zengcym/HDMI-To-MIPI/Images/2.jpg

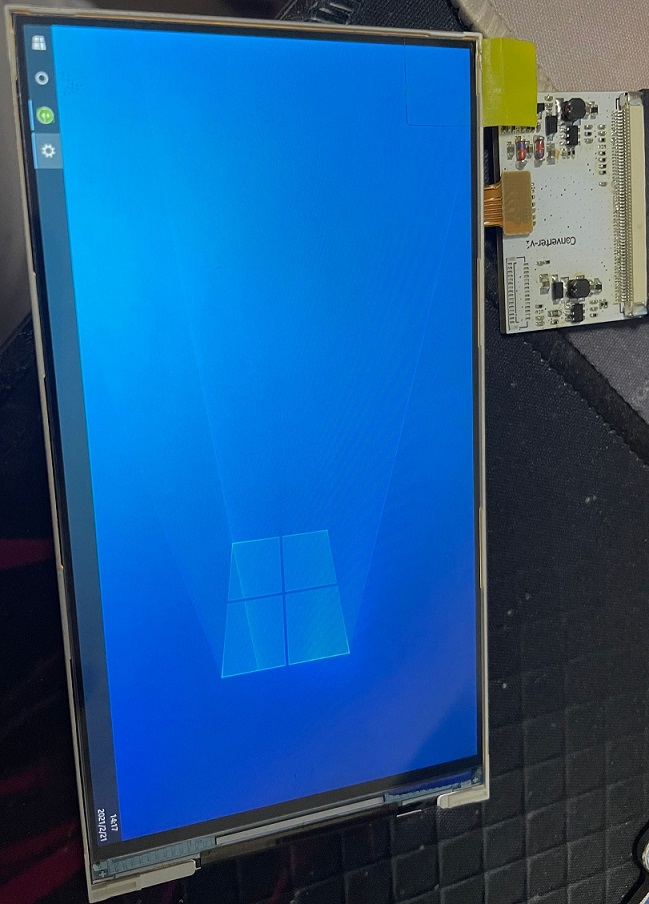
Images/2.jpg
