zengcym/HDMI-To-MIPI/Images/3.jpg

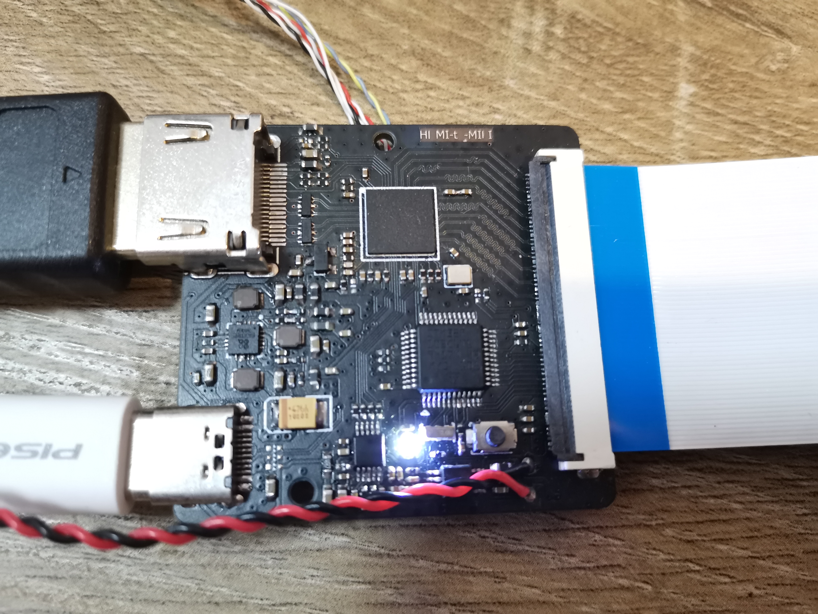
Images/3.jpg
