zengcym/HDMI-To-MIPI/Images/8-1.jpg

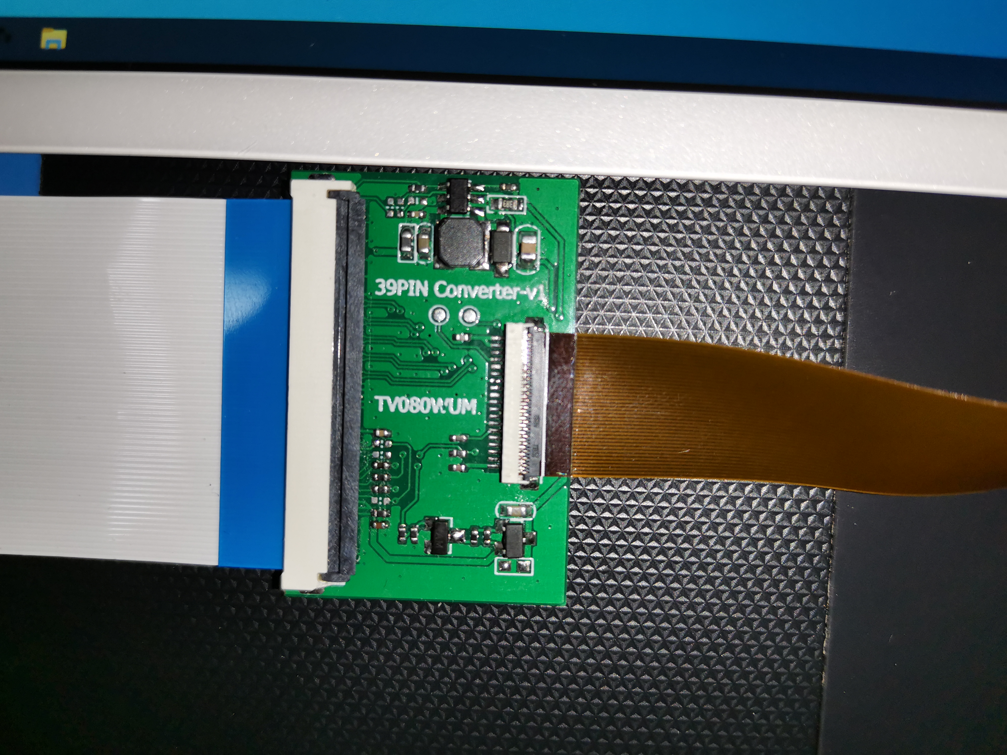
Images/8-1.jpg
