zengcym/HDMI-To-MIPI/Images/8.jpg

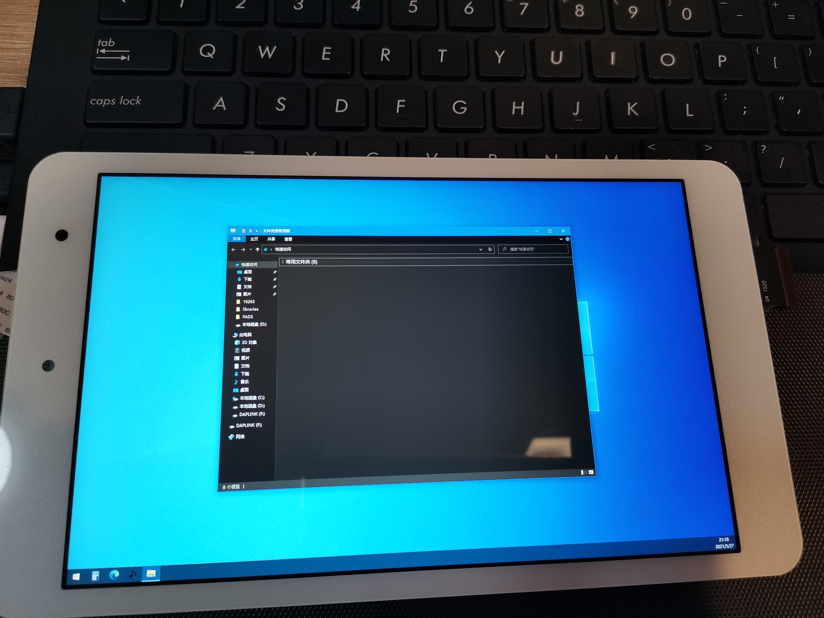
Images/8.jpg
