zengcym/HDMI-To-MIPI/Hardware/TC358870/HDMI to MIPI_v1 核心板BOM_V1.xlsx

Value | Decal | qty | Name
 |  | 5
 | TYPE-C-TOP | 1 | USB1
NS4150B | MSS0P8 | 1 | R52
ES7144LV | MSS0P10 | 1 | R45
EA3036C | QFN-20 | 1 | U1
SG-210STF 48M 2520 | ILFH2520 | 1 | U4
STM32F103CBT6 | LQFP-48 | 1 | U2
TC358870XBG | VFBGA-80 | 1 | U3
 |  | 59
0R | RES_0402 | 1 | R23
10R | L0603AA | 1 | R47
22R | RES_0402 | 2 | R5 R7
33R | RES_0402 | 9 | R15 R16 R21 R22 R28 R35 R36 R37 R38
470R | RES_0402 | 2 | R48 R49
1K | RES_0402 | 5 | R32 R33 R41 R42 R55
1.5K | RES_0402 | 2 | R39 R58
2K | RES_0402 | 3 | R10 R13 R26
10K | RES_0402 | 7 | R3 R8 R9 R18 R19 R50 R51
15K | RES_0402 | 1 | R6
27K | RES_0402 | 1 | R44
30K | RES_0402 | 3 | R53 R54 R59
47K | RES_0402 | 3 | R30 R31 R43
68K | RES_0402 | 1 | R4
91K | RES_0402 | 1 | R11
100K | RES_0402 | 3 | R2 R12 R57
200K | RES_0402 | 1 | R1
FB120R磁珠 | L0603AA | 7 | L5 R14 R17 R20 R27 R34 R56
10K | RES_0402 | 4 | R24 R25
2SC2712 | SOT23 | 1 | R40
 |  | 61
5P | CAP_0402 | 1 | C27
0.1U | CAP_0402 | 34 | C2 C3 C4 C5 C6 C8 C9 C10 C11 C12 C13 C14 C16 C17 C20 C22 C23 C24 C25 C26 C29 C31 C33 C34 C37 C38 C41 C42 C43 C46 C47 C48 C49 C56
1U | CAP_0402 | 2 | C39 C45
2.2U | CAP_0402 | 8 | C15 C21 C30 C35 C36 C53 C54 C55
4.7U | CAP_0402 | 1 | C40
10U | CAP_0402 | 1 | C32
10U | L0603B | 7 | C1 C7 C50 C51 C52 C57 C58
47U | 3528 | 1 | C44
RCLAMP0524PATCT | SLP2510P8 | 2 | E1 E2
NC | CAP_0402 | 4 | C18 C19 C28 C59
 |  | 7
1.5UH-252012H | 2520-L | 3 | L1 L2 L3
10UH | L0603AA | 1 | L4
10UF | L0603B | 2 | L6 L7
 |  | 2
LEDB | L0603BA | 1 | D1
LEDG | L0603BA | 1 | D2
 |  | 1
CSTCE8M00G52-R0 8MHz | ILFH-3P | 1 | Y1
 |  | 1
60P/0.5MM DOWN | FFC_0.5_60 | 1 | J1
 |  | 16
 | TEST_PTAA | 2 | T6 T7
 | TEST_PTC | 11 | T1 T5 T8 T9 T10 T11 T12 T13 T14 T15 T16
HDMI-19P | HDMI | 1 | HDMI?
3*4 KEY | BUTTONTACT_3X4X2_180H | 1 | K1
NC/4P-1.25-立式 | CON4-1.25MM | 1 | KCON1
