zengcym/HDMI-To-MIPI/Hardware/V2/BOM.xlsx

Value | Decal | qty | Name
0R | R0402 | 1 | R23
10R | R0603 | 1 | R47
33R | R0402 | 11 | R15 R16 R21 R22 R28 R35 R36 R37 R38 R5 R7
470R | R0402 | 2 | R48 R49
1K | R0402 | 5 | R32 R33 R41 R42 R55
1.5K | R0402 | 2 | R39 R58
2K | R0402 | 3 | R10 R13 R26
10K | R0402 | 9 | R3 R8 R9 R18 R19 R24 R50 R51 R61
15K | R0402 | 1 | R6
27K | R0402 | 1 | R44
47K | R0402 | 3 | R30 R31 R43 R53 R54 R59
68K | R0402 | 1 | R4
91K | R0402 | 1 | R11
100K | R0402 | 3 | R2 R12 R57
200K | R0402 | 1 | R1
4.7pF | C0402 | 1 | C27
20pF | C0402 | 2 | C60 C61
100nF | C0402 | 33 | C2 C3 C4 C5 C6 C8 C9 C10 C11 C12 C13 C14 C16 C17 C20 C22 C23 C24 C25 C26 C29 C31 C33 C34 C37 C38 C41 C42 C43 C46 C47 C49 C56
1uF | C0402 | 12 | C39 C45 C15 C21 C30 C32 C35 C36 C53 C54 C55 C40
10uF | C0603 | 9 | C1 C7 C50 C51 C52 C57 C58 L6 L7
