zengcym/HDMI-To-MIPI/Hardware/Converter 转接板/LT070ME05 31PIN V1.pdf

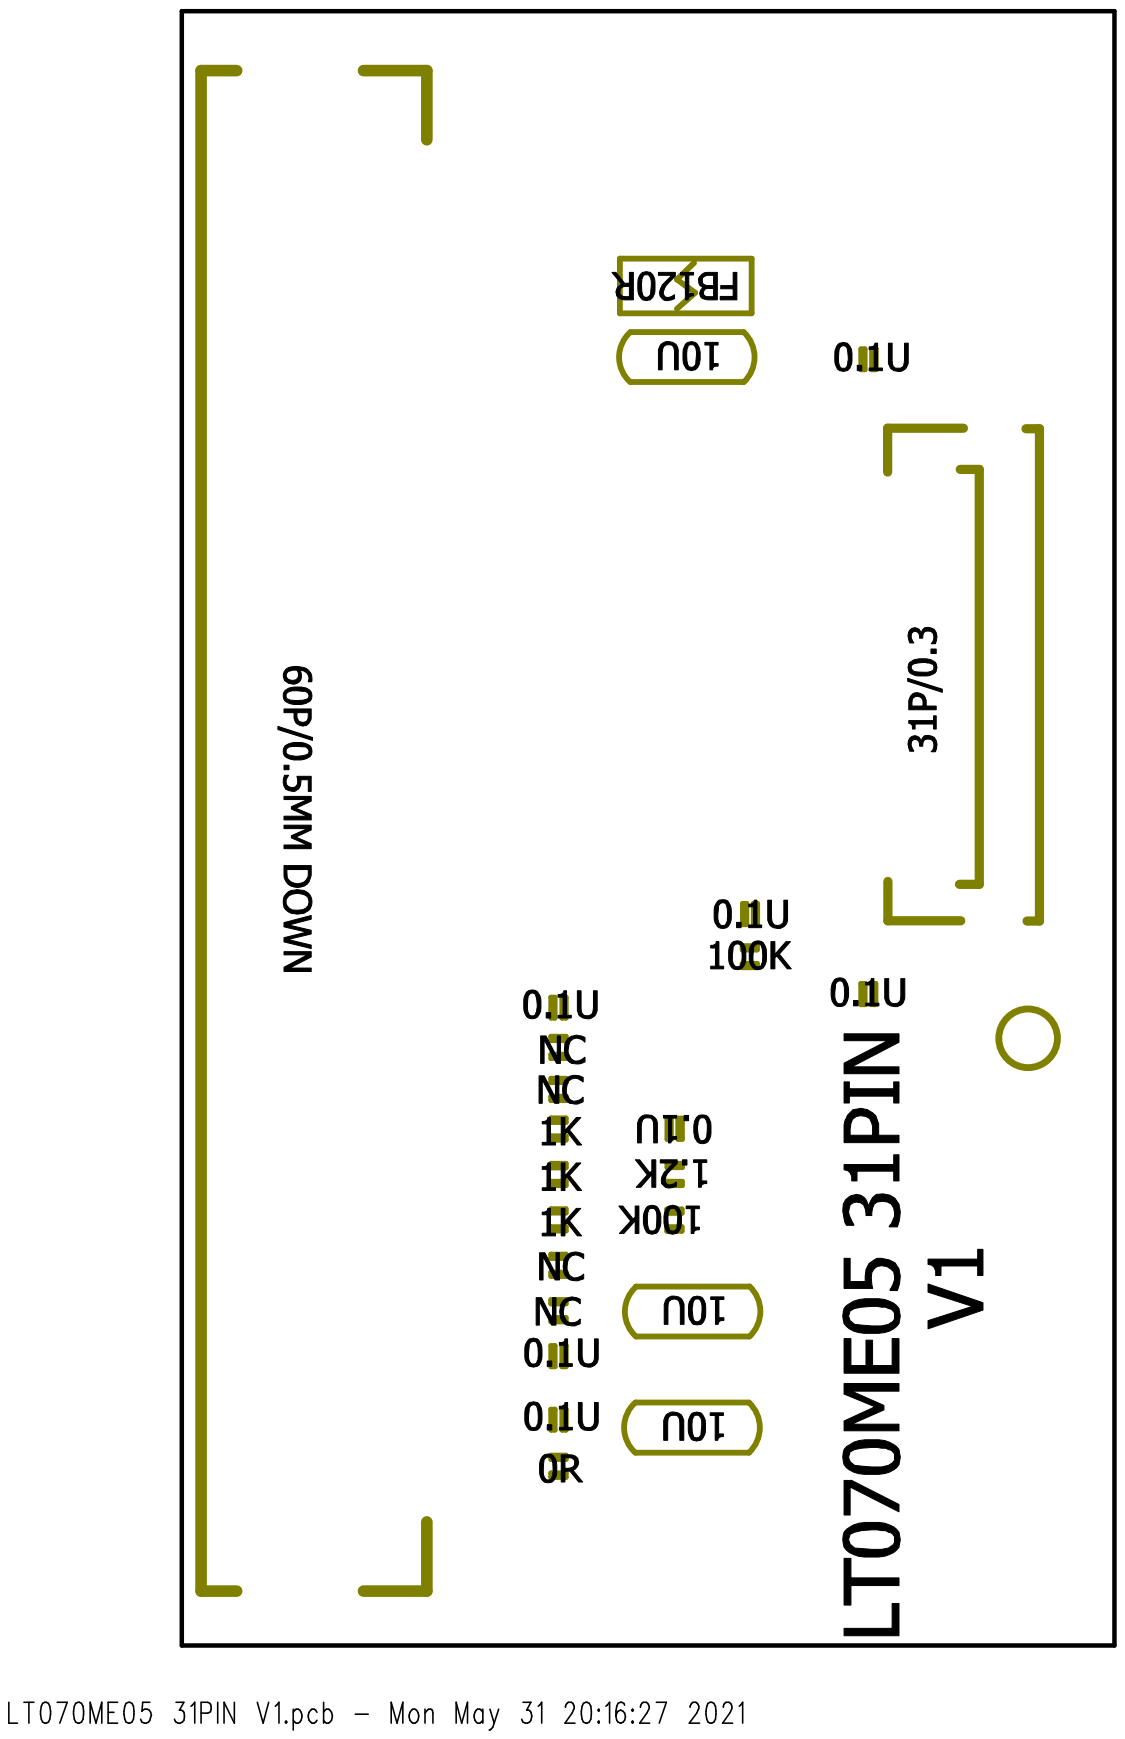
[picture p6: page 1]
