zengcym/HDMI-To-MIPI/Hardware/Converter 转接板/ILI9881C+BOE 10.1寸 Converter_v1.pdf

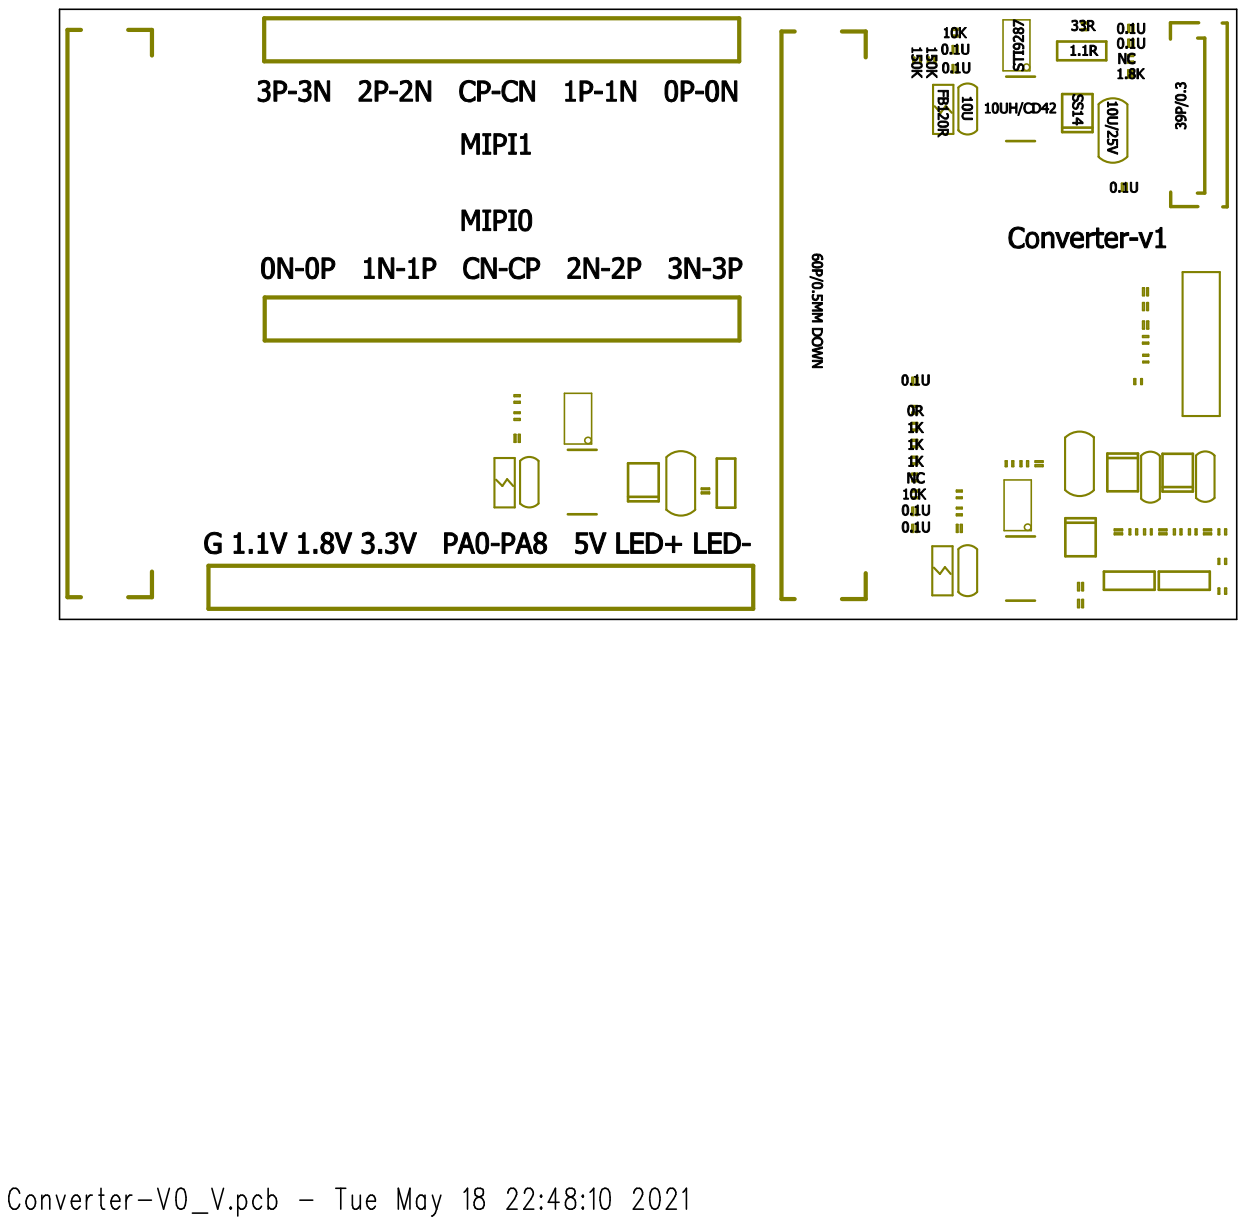
[picture p7: page 1]
