zengcym/HDMI-To-MIPI/Hardware/Converter 转接板/TV101WUM-NM0 51PIN Converter_V1 参数.pdf

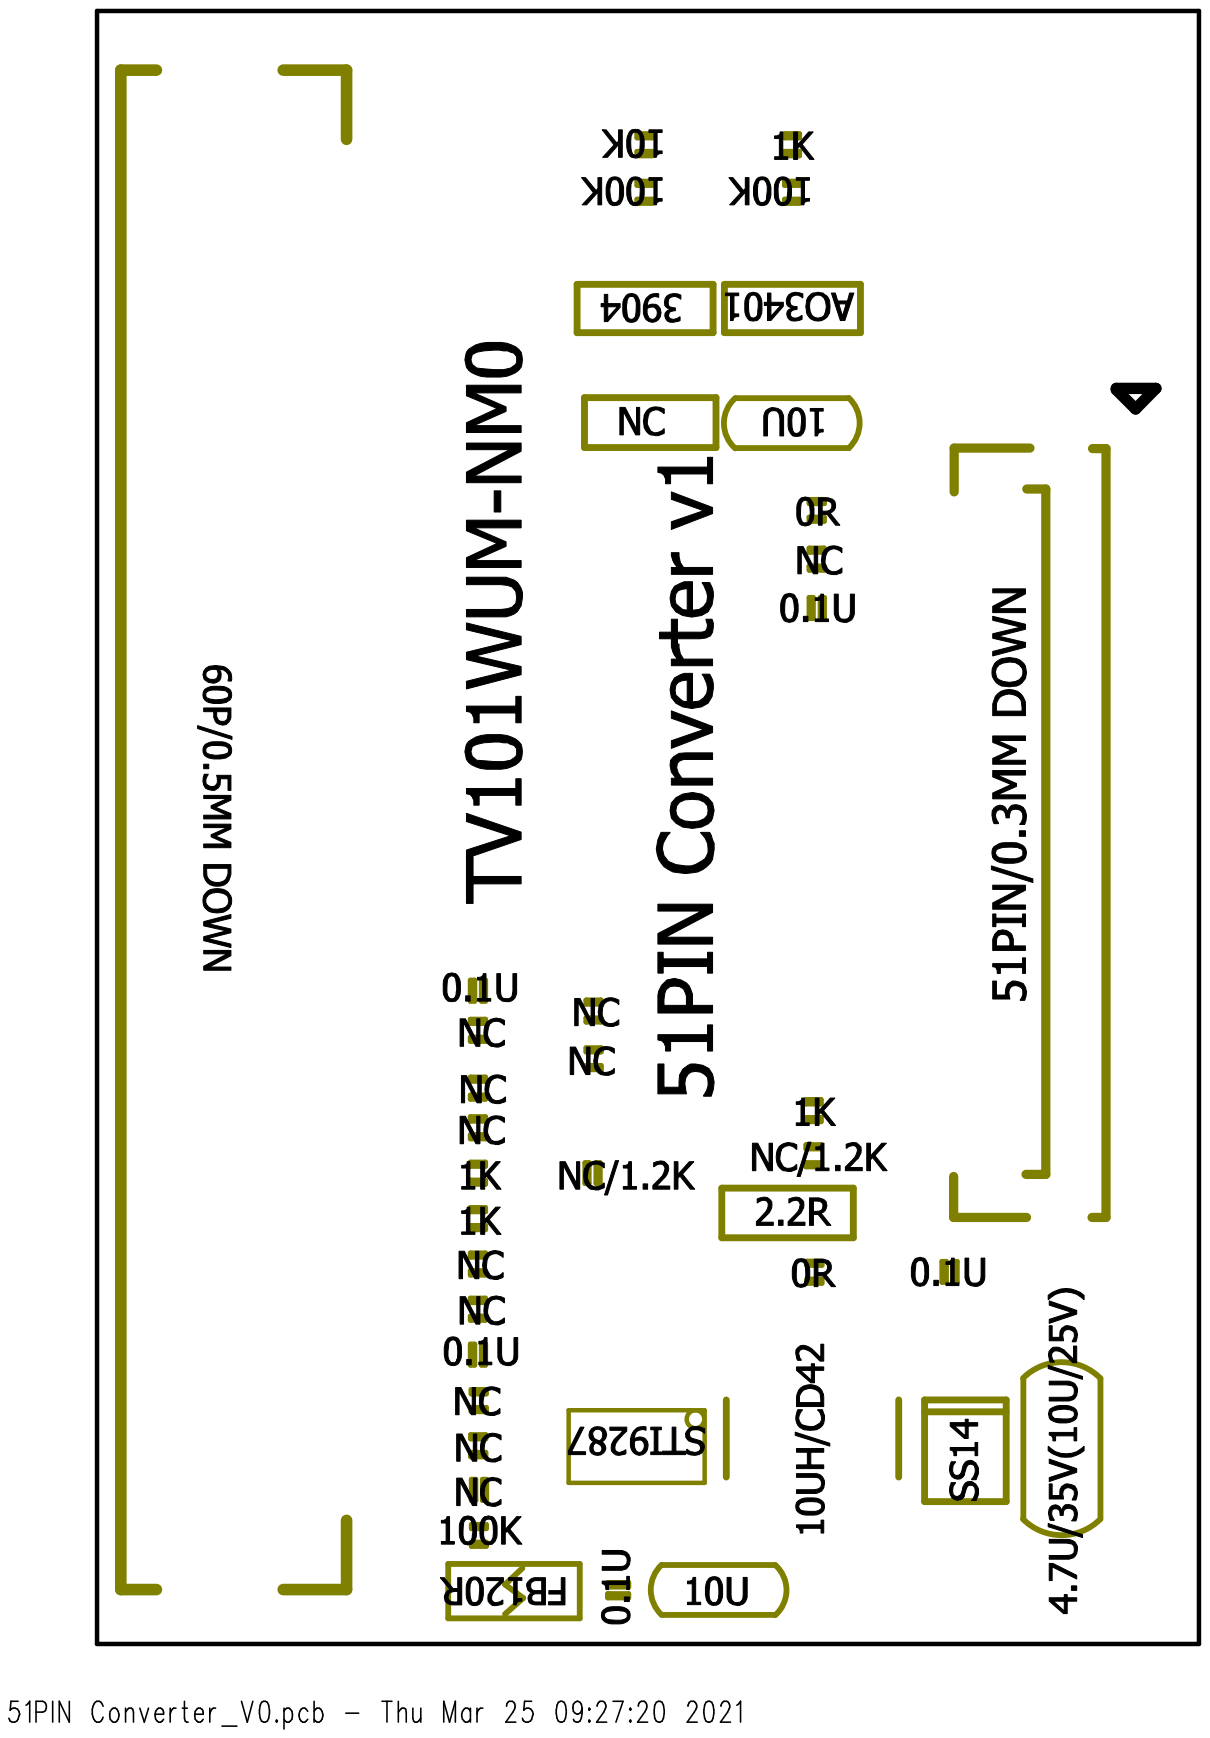
[picture p8: page 1]
