zengcym/HDMI-To-MIPI/Hardware/Converter 转接板/BV050HDM-N00 Converter_v1 参数-更改.pdf

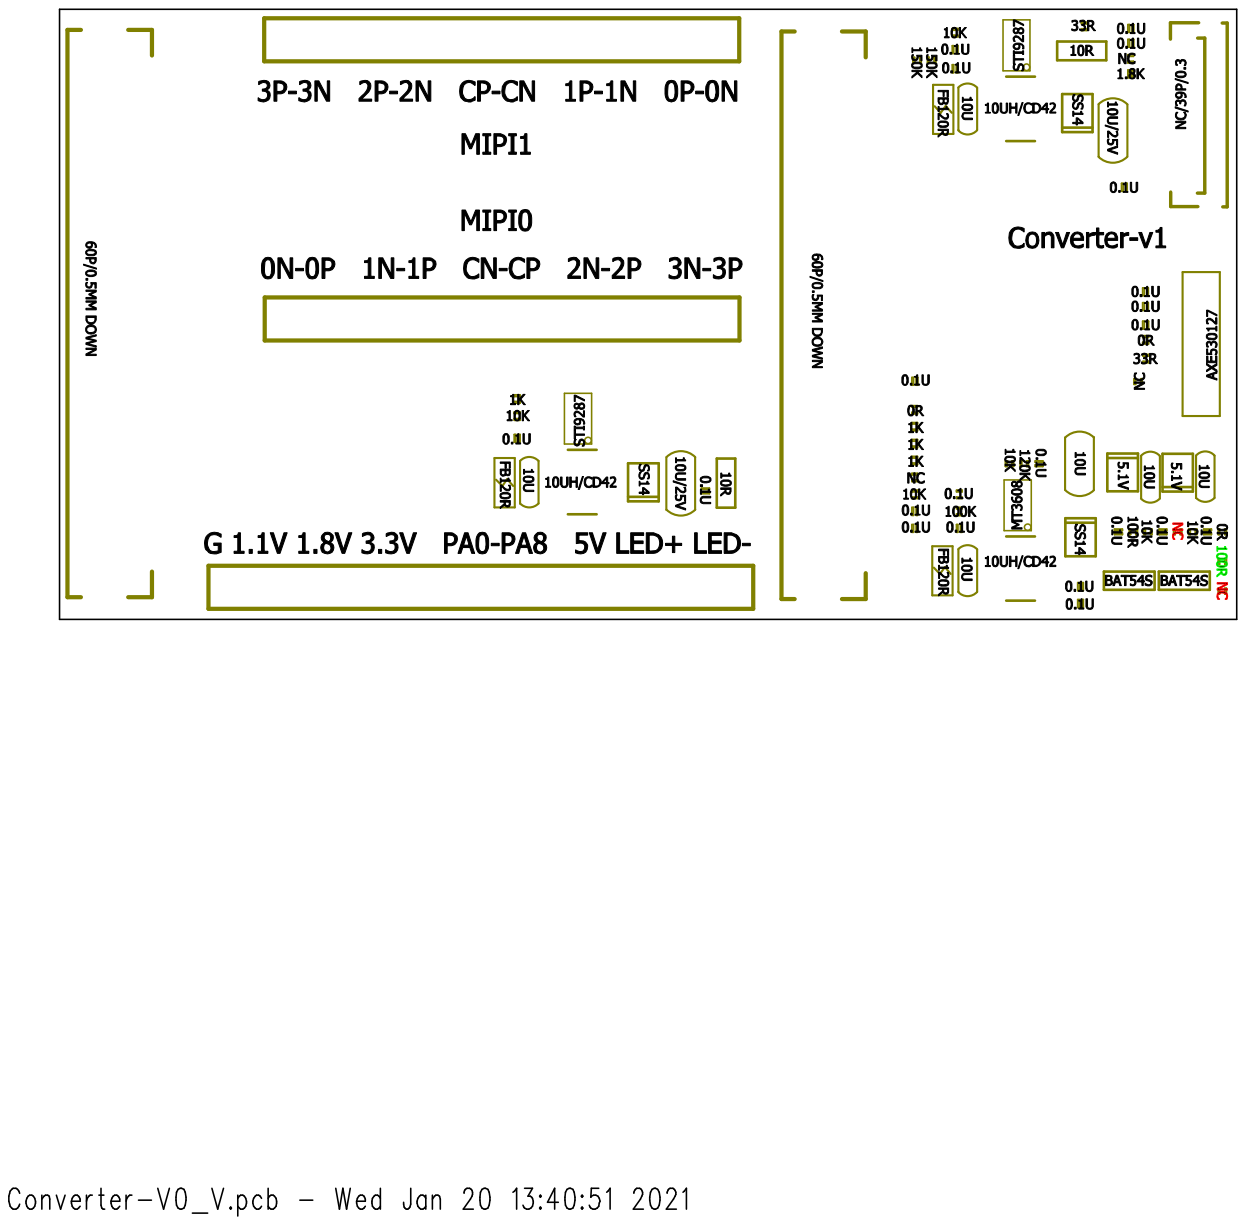
[picture p9: page 1]
