zengcym/HDMI-To-MIPI/Hardware/TC358870/HDMI to MIPI v1  位号.pdf

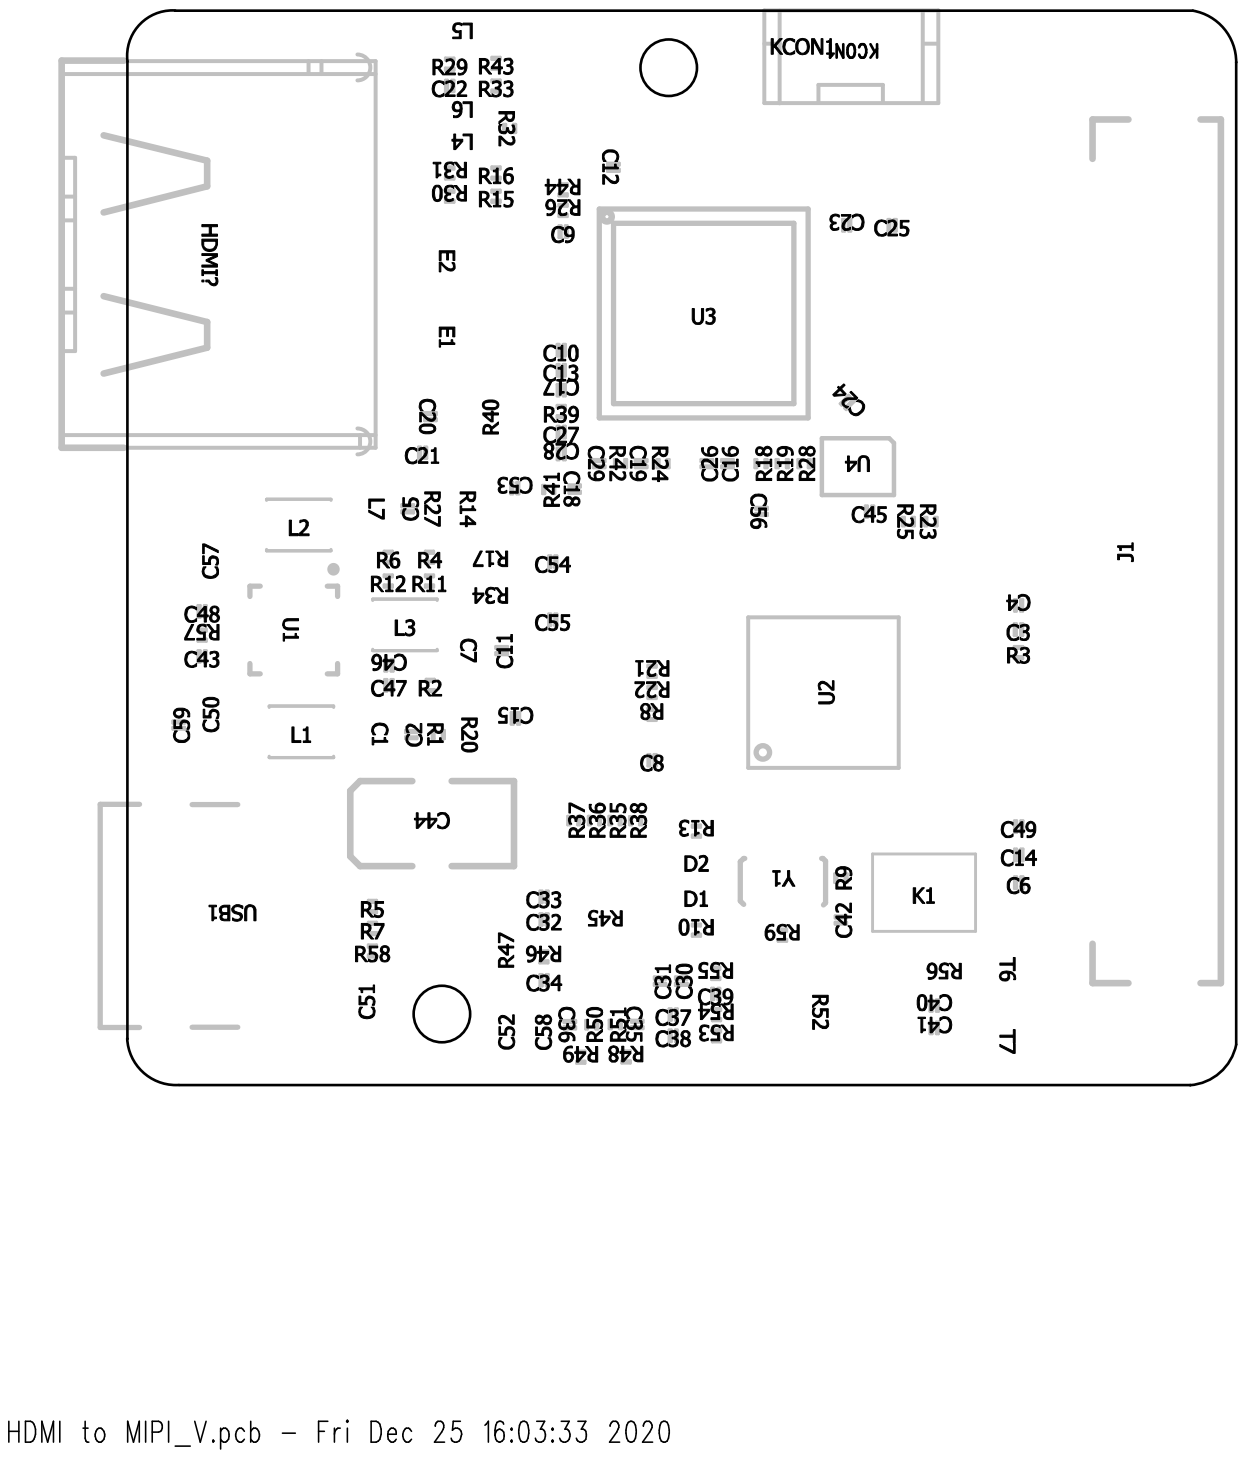
[picture p10: page 1]
