zengcym/HDMI-To-MIPI/Hardware/TC358870/HDMI to MIPI v1  参数.pdf

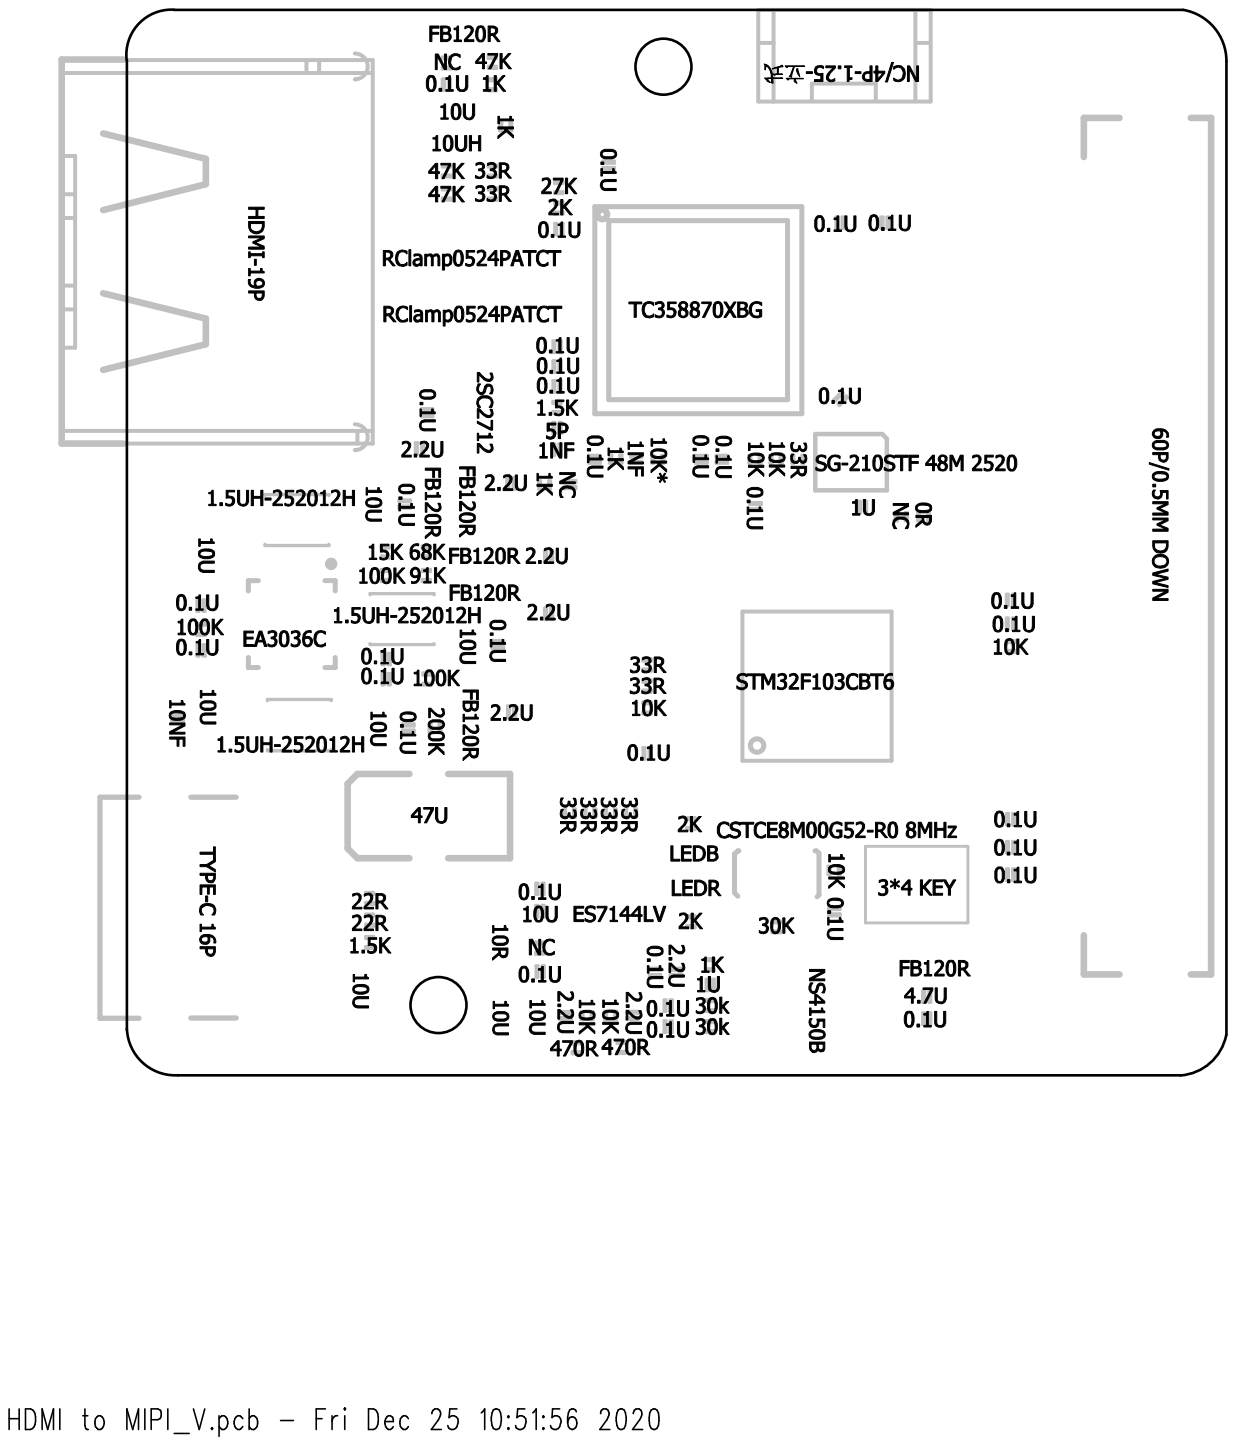
[picture p11: page 1]
