zengcym/HDMI-To-MIPI/(list of files, drawings)

Other design files:
Hardware/Converter 转接板/BV050HDM-N00 Converter_v1.pcb
Hardware/Converter 转接板/ILI9881C+BOE 10.1寸 Converter_v1.pcb
Hardware/Converter 转接板/LT070ME05 31PIN V1.pcb
Hardware/TC358870/HDMI to MIPI_v1.pcb
Hardware/V2/HDMI to MIPI_v2.pcb
