zengcym/HDMI-To-MIPI/(threads)

Thread 1 (2022-04-16):

请问有原理图吗？

1304963427, 2022-04-16:
请问有原理图吗？哪怕放个PDF原理图参考也行啊

epikao, 2022-12-01:
@zengcym , I would also be interested in the scheme, and would also pay something for it...

zengcym, 2023-02-01:
I'm sorry, I didn't follow the process to process the PCB, I don't have the scheme, please refer to this [[link](https://github.com/peng-zhihui/HDMI-PI),](url) I just added another DAC audio part.

Closed 2024-09-24.

Thread 2 (2023-01-02):

Development

craipe, 2023-01-02:
Hi friend. Can I ask you to share a project? I want to create a tablet on CM 4, but I can't find the correct circuit and trace of this board anywhere on the Internet, I found only Gerber files from you. I would be very grateful for your help. I can pay if required. If it doesn't bother you, export the project to Easy E DA PRO so that I can install it for myself.

嗨，朋友。 我可以请你分享一个项目吗? 我想在CM4上创建一个平板电脑，但我在互联网上的任何地方都找不到这个板的正确电路和痕迹，我只从你那里找到了Gerber文件。 我将非常感谢你的帮助。 如果需要，我可以付钱。 如果它不打扰您，请将项目导出到EasyEDA PRO，以便我可以自己安装它。

zengcym, 2023-02-01:
I'm not sure what you need, can you be specific？

oleqlazyrin, 2023-02-01:
> I'm not sure what you need, can you be specific？

I ask you to share the source data of the project so that I can implement it into my board. You have only Gerber files presented here.

zengcym, 2023-02-10:
Sorry, I use Mentor software to process the file, it is already in the shared document. You can do some conversion work yourself.

Closed 2024-09-24.
